HermanEcheverria/Porteros/Documentacion/figuras/calib_der.png

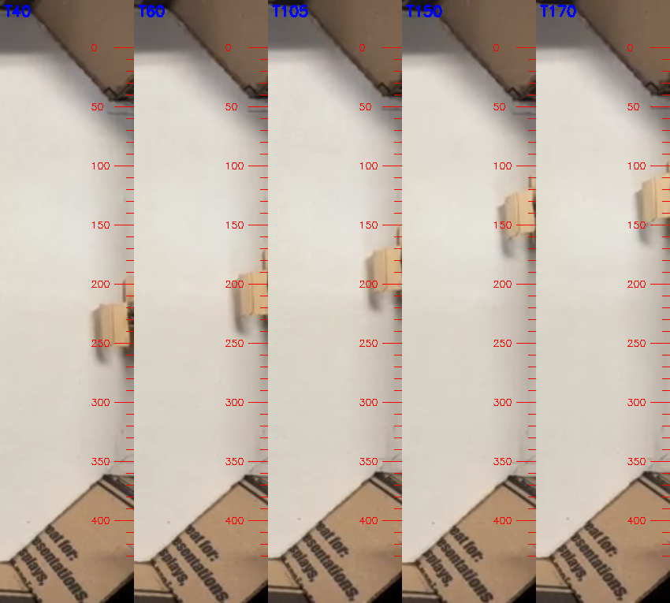
Documentacion/figuras/calib_der.png
