HermanEcheverria/Porteros/(commit log)

2026-11-06 Porteros Robot: firmware FreeRTOS, vision y documentacion
    - PORTERO_SERIAL: firmware de cada portero con FreeRTOS (tareas, colas,
    mutex, notificaciones, temporizador e ISR de finales de carrera)
    - vision: deteccion de la bola, Kalman, prediccion con rebotes, goles y marcador
    - Documentacion: documento tecnico (Word/PDF), diagramas y scripts
    - Pruebas individuales y registros CSV de las sesiones
    [20261030_180304.csv, 20261030_180307.csv, 20261030_181325.csv, 20261030_181351.csv, 20261030_181750.csv, 20261030_181834.csv, 20261030_184008.csv, 20261030_201924.csv]
2026-11-06 Documentacion: fotos de construccion y enlaces a Drive y GitHub
2026-11-07 Vision con bola azul y naranja; portada con escudo e integrantes
    - vision_cancha.py: busca los dos colores a la vez (perfiles azul y naranja);
    B elige cual color ajustan los sliders y el clic derecho
    - calibracion.json: esquinas de la camara actual y los dos colores
    - Documento tecnico: escudo UNIS, integrantes y mencion de la bola naranja
    [20261105_203047.csv]
